Lor7/WRO2024-FUTURE-ENGINEERS-VOLTERRA-TEAM-INTERNATIONAL-FINAL/src/README.md

This folder contains the source of the control software.
"Open Round" and "Obstacle Round" folder respectively contains the code for the open and obstacle challenges (to be uploaded on the Raspberry Pi 5).
"cameraFeed.py" is a utility file that must be placed in the desktop folder of the Raspberry Pi 5.
"arduinoNanoServo" contains the sketch to be uploaded on the Arduino Nano.
