Lor7/WRO2024-FUTURE-ENGINEERS-VOLTERRA-TEAM-INTERNATIONAL-FINAL/schemes/README.md

This folder contains electrical and mechanical schematic diagrams in JPG format
