Lor7/WRO2024-FUTURE-ENGINEERS-VOLTERRA-TEAM-INTERNATIONAL-FINAL/other/library_used.md

#### Key Libraries:
<table>
<tr><td><b>gpiozero:</b></td><td>Simplifies controlling Raspberry Pi GPIO pins. Perfect for working with hardware like LEDs and sensors. 
</td></tr>
<tr><td><b>opencv:</b></td><td> A powerful tool for image and video processing. It's used here for analyzing images, detecting objects, and handling live video feeds.
</td></tr>
<tr><td><b>tensorflow:</b></td><td> Ideal for machine learning tasks. It helps with creating AI models to recognize patterns or objects in images. 
</td></tr>
<tr><td><b>numpy:</b></td><td> Makes working with numbers and large datasets fast and efficient. It's a foundation for libraries like TensorFlow and OpenCV.
</td></tr>
<tr><td><b>zmq:</b></td><td>Enables fast and efficient communication between different processes. We use it to transfer data between the camera and main processes.
</td></tr>
<tr><td><b>picamera:</b></td><td>A library tailored to control the Raspberry Pi camera module. The latest version, Picamera2, works well with modern hardware and offers better performance.
</td></tr>
</table>
