Lor7/WRO2024-FUTURE-ENGINEERS-VOLTERRA-TEAM-INTERNATIONAL-FINAL/other/backstage_photos/backstage5.jpg

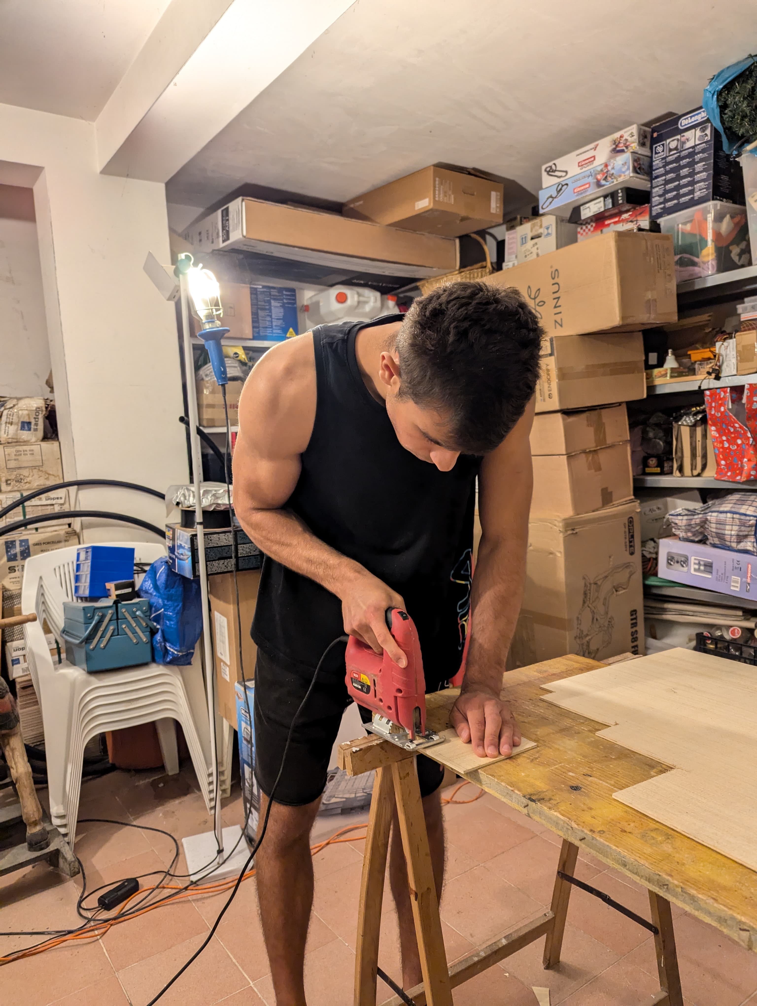
other/backstage_photos/backstage5.jpg
