Lor7/WRO2024-FUTURE-ENGINEERS-VOLTERRA-TEAM-INTERNATIONAL-FINAL/other/media/gear_motor.webp

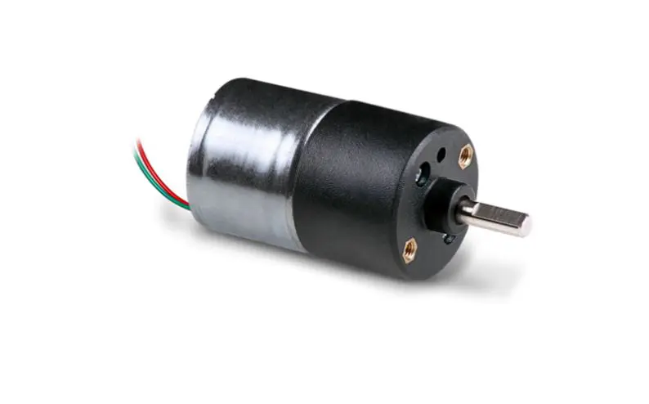
other/media/gear_motor.webp
