Lor7/WRO2024-FUTURE-ENGINEERS-VOLTERRA-TEAM-INTERNATIONAL-FINAL/v-photos/back_view.jpg

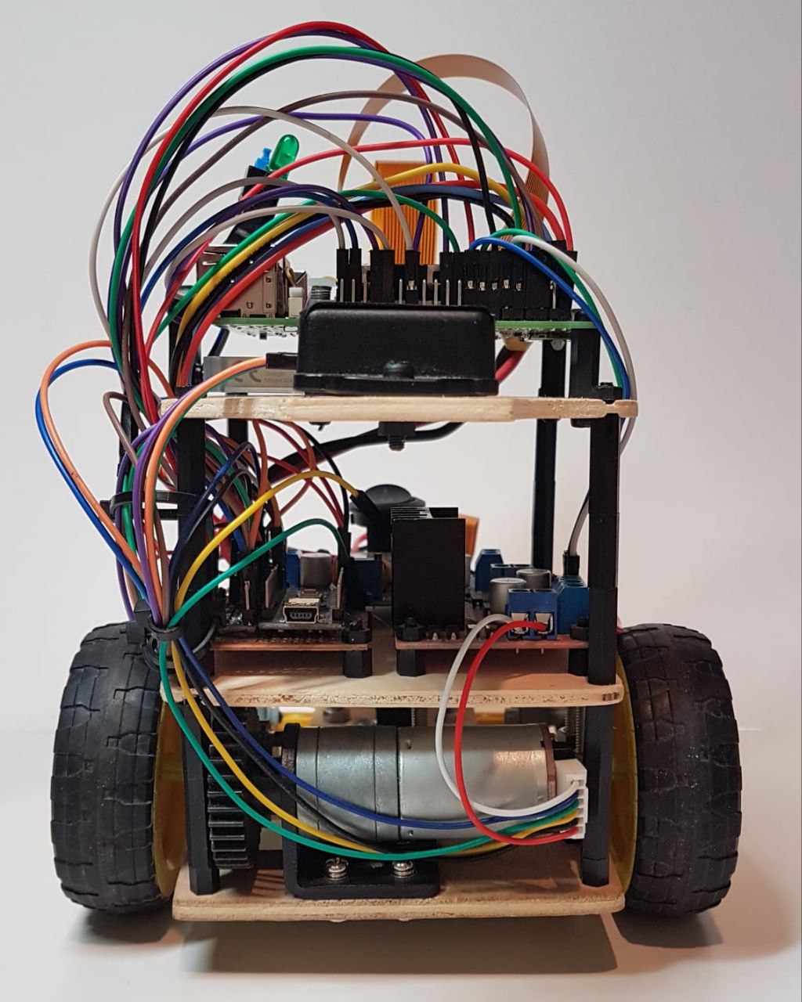
v-photos/back_view.jpg
