Lor7/WRO2024-FUTURE-ENGINEERS-VOLTERRA-TEAM-INTERNATIONAL-FINAL/v-photos/bottom_view.jpeg

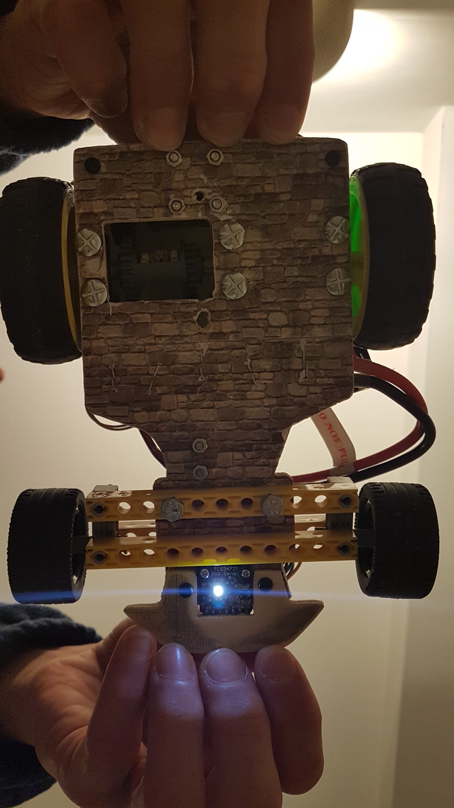
v-photos/bottom_view.jpeg
