Lor7/WRO2024-FUTURE-ENGINEERS-VOLTERRA-TEAM-INTERNATIONAL-FINAL/v-photos/front_view.jpg

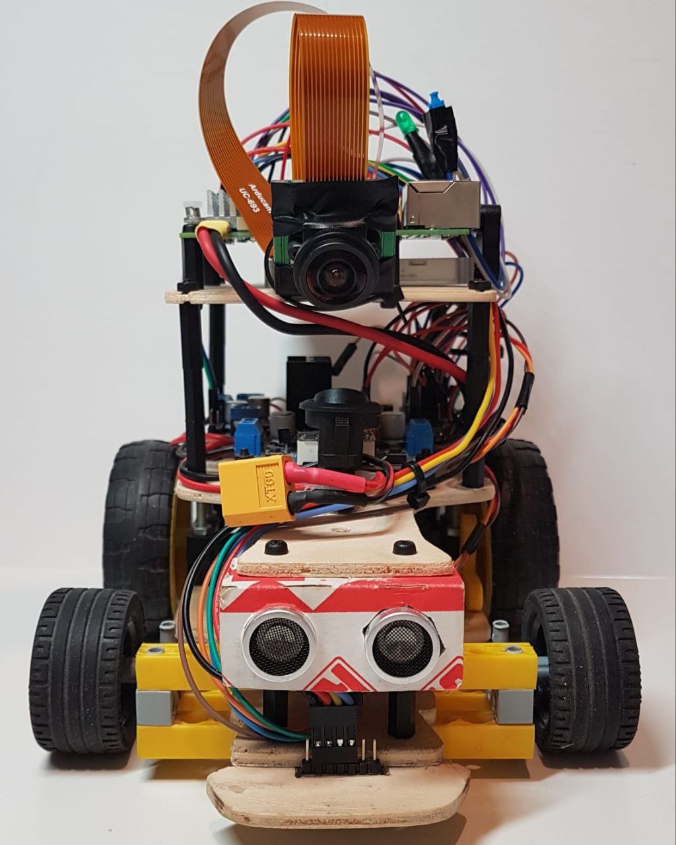
v-photos/front_view.jpg
