Lor7/WRO2024-FUTURE-ENGINEERS-VOLTERRA-TEAM-INTERNATIONAL-FINAL/v-photos/inner_view.jpg

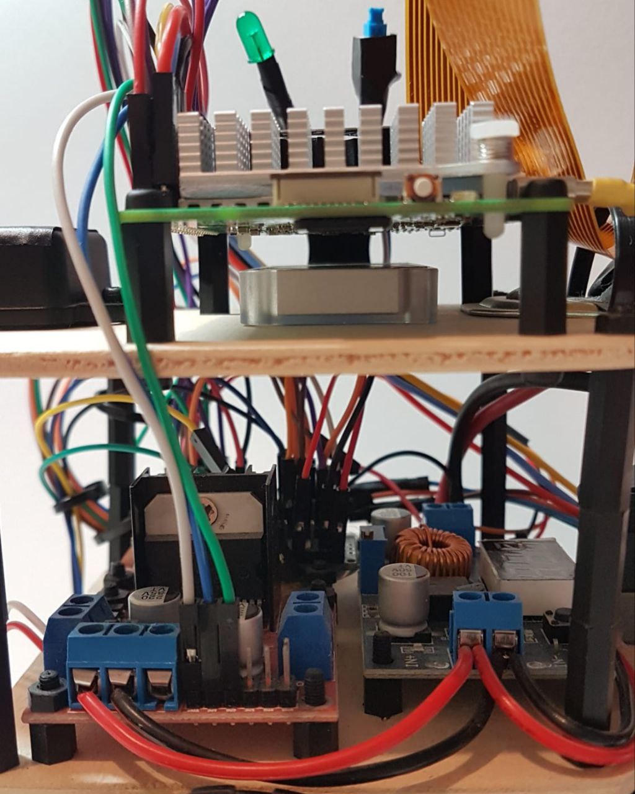
v-photos/inner_view.jpg
