Lor7/WRO2024-FUTURE-ENGINEERS-VOLTERRA-TEAM-INTERNATIONAL-FINAL/v-photos/left_view.jpg

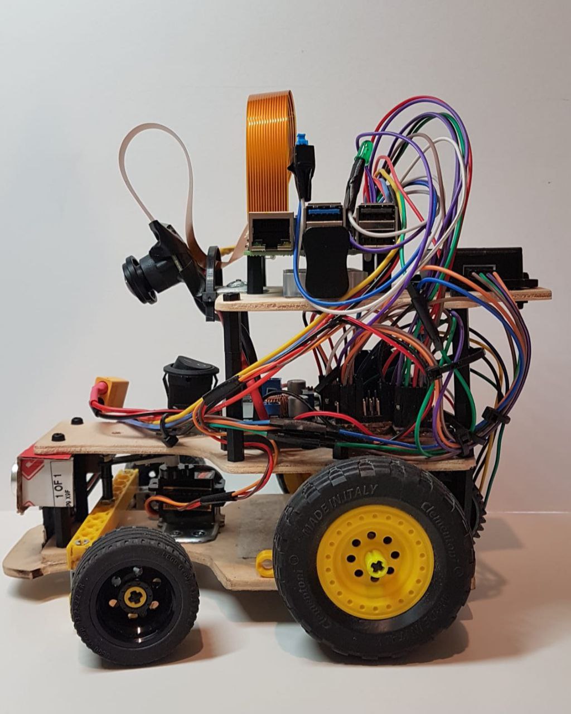
v-photos/left_view.jpg
