Lor7/WRO2024-FUTURE-ENGINEERS-VOLTERRA-TEAM-INTERNATIONAL-FINAL/(commit log)

2024-09-16 Initial commit
    - Upload of files that handle sensors/actuators, image processing and files with variables/constants/classes
    - It's been uploaded the main files regarding the Open Challenge round and the Obstacle Challenge round, they handle the logic and other modules/functions
2024-09-18 Reverse movement implemented and color sensor analyzer implement
    [actuators.py, openRound.py]
2024-09-20 Implemented option to save frame
2024-09-22 improvements for the wall avoidance algorithm
    [brain.py, finalImageProcessing.py]
2024-10-04 Added debug visualization on the frame
2024-10-05 Implemented processing of IMU data
2024-10-05 Improved steering logic
2024-10-10 Adjusted steering to be more accurate
2024-10-20 Implemented parking + led button start + improved wall avoidance algorithm
    [brain.py, openRound.py]
2024-10-30 implementation of obstacle'color memory for reverse
    [obstacleAlgorithm.py]
2024-11-12 readme - Engineering Factor, Explanation about Ackermann Steering System
2024-11-17 Added a check to see if the vehicle gets stuck during round about
    [obstaclesRound.py]
2024-11-18 Mobility Management, Power Management, Sense Management
2024-11-18 Clarifications for Power Management
2024-11-19 upload of the control software flowchart
2024-11-21 Trajectories illustrations, prototype setup and assembly, components cost
2024-11-22 Added ackermann steering images
2024-11-23 Improvements in the parking algorithm: reverse
    [obstaclesRound.py, park.py]
2024-11-24 arduino nano sketch + use of zmq and picamera2 for camera readings
2024-11-25 Uploaded visual wiring scheme
2024-11-25 Uploaded corrected visual wiring scheme
2024-11-25 Added image of "visual wiring scheme.jpg"
